hungbk99/RVS192-CPU/testbench/arrangement_cache_test1.txt

00100093
0005f593
00057513
00047413
0004f493
00097913
0009f993
000a7a13
000afa93
000b7b13
000bfb93
000c7c13
000cfc93
000d7d13
00037313
00a30313
000fff93
00002483
00402903
00802983
00c02a03
01002a83
01402b03
01802b83
01c02c03
02002c83
02402d03
0124a433
00808e63
412482b3
00500a63
00900533
00090493
00050913
00047413
01392433
00808e63
413902b3
fe500ae3
01200533
00098913
00050993
00047413
0149a433
00808e63
414982b3
00500a63
01300533
000a0993
00050a13
00047413
015a2433
00808e63
415a02b3
00500a63
01400533
000a8a13
00050a93
00047413
016aa433
00808e63
416a82b3
00500a63
01500533
000b0a93
00050b13
00047413
017b2433
00808e63
417b02b3
00500a63
01600533
000b8b13
00050b93
00047413
018ba433
00808e63
418b82b3
00500a63
01700533
000c0b93
00050c13
00047413
019c2433
00808e63
419c02b3
00500a63
01800533
000c8c13
00050c93
00047413
01aca433
00808c63
41ac82b3
00500863
01900533
000d0c93
00050d13
00047413
00158593
00b30463
ed9ff3ef
02902423
03202623
03302823
03402a23
03502c23
03602e23
05702023
05802223
05902423
05a02623
1fff8f93
02802503
02c02583
03002603
03402683
03802703
03c02783
04002803
04402883
04802e03
04c02e83
