hungbk99/RVS192-CPU/testbench/arrangement_test.txt

01700293
0051a023
01700293
0051a223
fff00293
0051a423
01100293
0051a623
00a00293
0051a823
ff600293
0051aa23
01100293
0051ac23
00400293
0051ae23
00b00293
0251a023
01700293
0251a223
00900293
00900413
00a00f13
00000493
0001a303
0900006f
00900f13
00400493
0041a303
0800006f
00800f13
00800493
0081a303
0700006f
00700f13
00c00493
00c1a303
0600006f
00600f13
01000493
0101a303
0500006f
00500f13
01400493
0141a303
0400006f
00400f13
01800493
0181a303
0300006f
00300f13
01c00493
01c1a303
0200006f
00200f13
02000493
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
00af2f93
000f9863
006003b3
00900933
f61ff06f
04734463
006003b3
00900933
03c0006f
020a8063
01d34663
03d31863
1480006f
006003b3
00900933
00000a93
01c0006f
01d34663
01d31a63
12c0006f
00734663
006003b3
00900933
00af2f93
f00f88e3
009f2f93
f00f8ce3
008f2f93
f20f80e3
007f2f93
f20f84e3
006f2f93
f20f88e3
005f2f93
f20f8ce3
004f2f93
f40f80e3
003f2f93
f40f84e3
002f2f93
f40f88e3
0040006f
00700eb3
0092af93
000f9863
0471a623
0f21a623
0ac0006f
0082af93
000f9863
0471a423
0f21a423
0980006f
0072af93
000f9863
0471a223
0f21a223
0840006f
0062af93
000f9863
0471a023
0f21a023
0700006f
0052af93
000f9863
0271ae23
0d21ae23
05c0006f
0042af93
000f9863
0271ac23
0d21ac23
0480006f
0032af93
000f9863
0271aa23
0d21aa23
0340006f
0022af93
000f9863
0271a823
0d21a823
0200006f
0012af93
000f9863
0271a623
0d21a623
00c0006f
0271a423
0d21a423
12028463
fff28293
00100a93
dedff06f
0082af93
0ec1aa03
01449463
ed9ff06f
000f1663
ec0f82e3
0080006f
ea0f80e3
0072af93
0e81aa03
01449463
eb9ff06f
000f1663
ea0f82e3
0080006f
e80f80e3
0062af93
0e41aa03
01449463
e99ff06f
000f1663
e80f82e3
0080006f
e60f80e3
0052af93
0e01aa03
01449463
e79ff06f
000f1663
e60f82e3
0080006f
e40f80e3
0042af93
0dc1aa03
01449463
e59ff06f
000f1663
e40f82e3
0080006f
e20f80e3
0032af93
0d81aa03
01449463
e39ff06f
000f1663
e20f82e3
0080006f
e00f80e3
0022af93
0d41aa03
01449463
e19ff06f
000f1663
e00f82e3
0080006f
de0f80e3
0012af93
0d01aa03
01449463
df9ff06f
000f1663
de0f82e3
0080006f
dc0f80e3
0002af93
0cc1aa03
01449463
dd9ff06f
000f1263
da0f84e3
